ofisheljames108-ship-it/JF-Audio/README.md

# JF-Audio

A multi-generation Bluetooth speaker engineering project documenting the complete design process from prototype to custom PCB and beyond.

<p align="center">
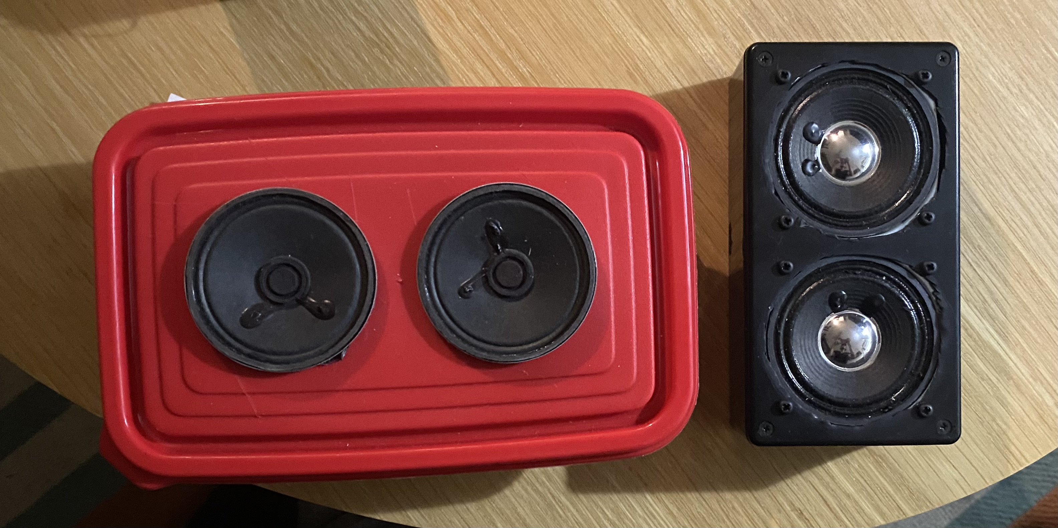
[picture p1: Images/JF_Audio_V1_V2_Comparison.jpeg]
  
</p>

This project follows the development of a portable Bluetooth speaker through multiple design iterations, beginning with a breadboard prototype and progressing toward a custom PCB-based system.

## Project Overview

JF-Audio is a personal electrical engineering project focused on designing and
developing a portable Bluetooth speaker system through multiple hardware
revisions.

The project began as a breadboard-based prototype using off-the-shelf modules
and has progressed into a custom PCB-based design integrating Bluetooth audio,
stereo amplification, rechargeable battery power, and enclosure development.

Each version of the project builds upon lessons learned from the previous
design.

---

## Project Generations

## Version 1 — Breadboard Prototype

The first version of JF-Audio was constructed using off-the-shelf modules and a breadboard to validate the Bluetooth audio system before designing custom hardware.

<p align="center">
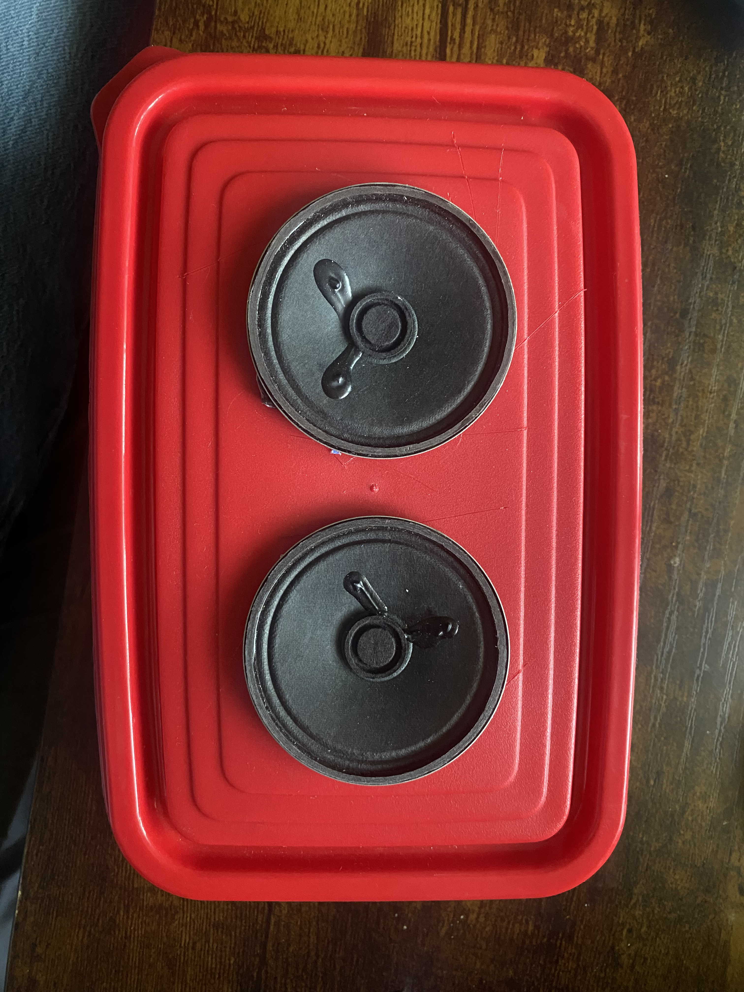
[picture p2: Version-1_Prototype/Photos/v1_finished_speaker.jpg]
  
</p>

The prototype was used to verify Bluetooth connectivity, stereo audio output, power distribution, and overall system functionality.

Key accomplishments:

- Bluetooth audio connectivity
- Stereo speaker output
- PAM8403 amplifier module integration
- Portable battery-powered operation
- Functional enclosure prototype

[View Version 1](Version-1_Prototype/)

---

## Version 2 — Custom PCB

Version 2 replaces the breadboard-based audio circuitry with a custom PCB
designed in EasyEDA. The board integrates the PAM8403 stereo audio amplifier,
passive components, Bluetooth connections, speaker outputs, and power
connections.

<p align="center">
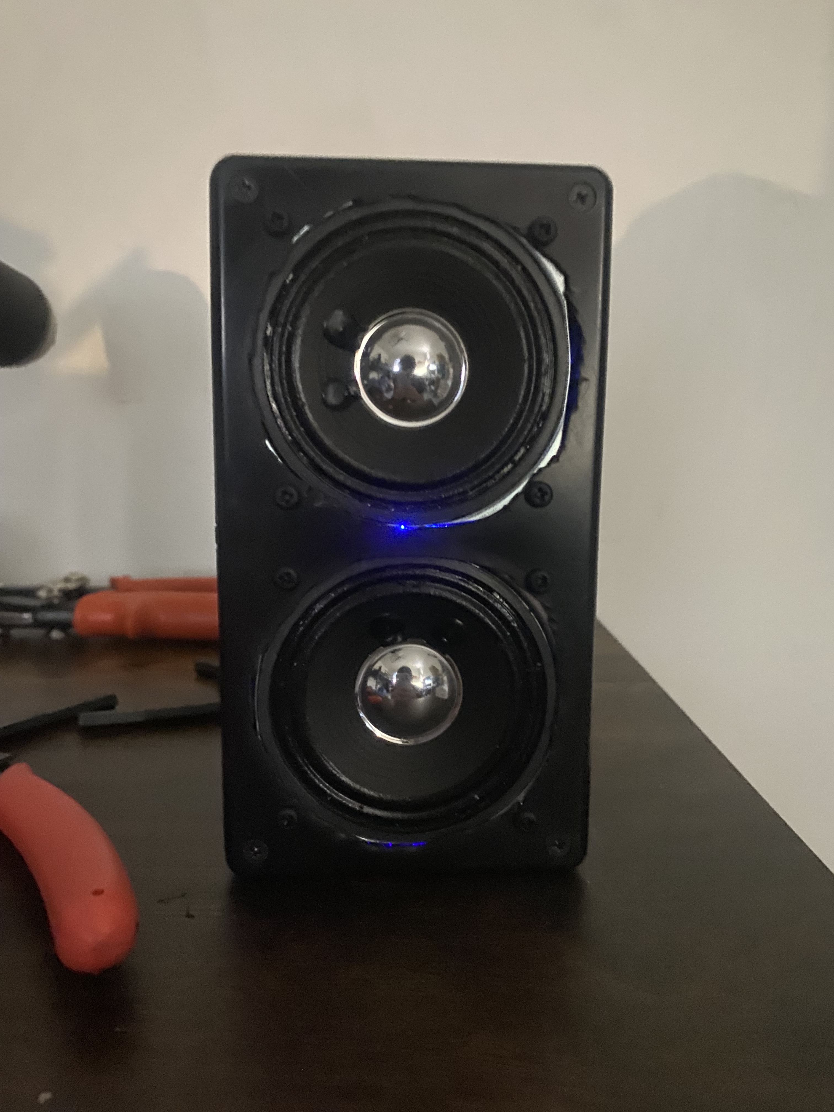
[picture p3: Version-2_Custom-PCB/Enclosure_Photos/Completed_JF_Audio_V2.jpg]
  
</p>

Version 2 transitioned JF Audio from a breadboard prototype into a custom
hardware platform.

The design introduced a custom PAM8403 amplifier PCB, rechargeable Li-ion
power system, battery protection, external power control, and a fully
integrated portable enclosure.

**Key accomplishments:**
- Custom PAM8403 amplifier PCB
- PCB manufacturing and hand assembly
- Rechargeable 18650 Li-ion power system
- Battery protection integration
- PowerBoost 1000C charging and power management
- External power switch
- Stereo Bluetooth playback
- Extended battery-powered playback testing
- Complete enclosure integration

**Current Status:** Final integration and validation. The assembled system has
successfully demonstrated Bluetooth connectivity, stereo audio playback,
battery-powered operation, charging, simultaneous charging and playback, and
a 2.5-hour post-assembly playback test.

The remaining mechanical issue is improving charging-port clearance to allow
the Micro-USB cable to fully seat, followed by final assembled charging and
charge-and-play validation.

[View Version 2](Version-2_Custom-PCB/)
---

### Version 3 — Integrated Product Design

**Planned**

Version 3 will focus on improving the mechanical and electronic integration
of JF Audio based on lessons learned during Version 2.

Planned development includes:
- Custom 3D-printed enclosure
- Purpose-designed component mounting locations
- Improved external connector integration
- Physical audio controls
- Improved audio processing
- More integrated electronics

### Version 4 — Advanced Embedded Audio System

**Planned**

Version 4 is intended to expand JF Audio into an advanced embedded audio
platform incorporating DSP, embedded control, system telemetry, display
integration, and deeper custom electronics.

### Version 5 — Advanced Hardware Platform

**Long-Term Concept**

Version 5 is intended to explore deeper custom hardware development,
advanced audio processing, custom display electronics, and increasingly
integrated system architecture.

---

## Design Philosophy

JF Audio follows an iterative engineering approach in which each generation
is used to identify limitations and establish requirements for the next design.

The project progression emphasizes:

- Increasing levels of custom hardware development
- Improved electrical and mechanical integration
- PCB design and hardware debugging
- Power-management and battery-system development
- Embedded control and digital signal processing
- Experimental testing and design validation
- Documentation of both successful designs and engineering challenges

Rather than treating each version as an independent project, lessons learned
from each generation directly influence the architecture of the next.

## Development Progress

**Version 1:** Complete  
**Version 2:** Hardware bring-up and enclosure integration in progress  
**Version 3:** Concept development

Version 2 has successfully demonstrated Bluetooth connectivity and stereo
audio operation using the custom PCB. Power-system integration and final
mechanical assembly are currently in progress.

---

## Engineering Areas

This project includes practical experience with:

- PCB schematic capture and layout
- EasyEDA
- PAM8403 Class-D audio amplification
- Bluetooth audio integration
- Lithium-ion battery power systems
- DC-DC power conversion
- Soldering and hardware assembly
- Digital multimeter testing
- PCB bring-up
- Hardware troubleshooting
- Enclosure design
- Design-for-assembly considerations
- Engineering documentation

---

## Repository Structure

```text
JF-Audio/
│
├── Version-1_Prototype/
│   └── Original breadboard-based Bluetooth speaker
│
├── Version-2_Custom-PCB/
│   └── Custom PCB, rechargeable power system, testing, and enclosure
│
├── Version-3_Concept/
│   └── Integrated electronics and custom enclosure development
|
├── Images/
│   └── Project-level images and generation comparisons
│
├── LICENSE
└── README.md
```
