ofisheljames108-ship-it/JF-Audio/Version-3_Concept/README.md

# JF Audio Version 3 — Concept Development

## Overview

JF Audio Version 3 is the planned next generation of the JF Audio Bluetooth
speaker platform.

Version 3 will build upon the electrical and mechanical lessons learned during
the development of Version 2, with a greater emphasis on product-level
integration, mechanical design, user controls, and serviceability.

Version 3 is currently in the concept and requirements-development phase.
Hardware specifications may change as the design progresses.

## Motivation

Version 2 successfully transitioned JF Audio from a breadboard prototype to a
rechargeable system built around a custom amplifier PCB.

However, final assembly identified several areas for improvement, particularly
in mechanical integration.

These observations directly establish several requirements for Version 3:

- Purpose-designed enclosure rather than a modified off-the-shelf enclosure
- Precisely dimensioned speaker openings and mounting features
- Dedicated mounting locations for internal electronics
- Improved charging-port integration
- Improved component accessibility and serviceability
- Cleaner internal wiring and system organization

## Preliminary Design Goals

Version 3 is expected to explore:

- Custom 3D-printed enclosure
- Purpose-designed internal component mounts
- Improved custom PCB integration
- USB-C charging
- Improved Bluetooth integration
- Physical volume control
- Mute control
- Playback controls
- User-selectable EQ functionality
- Status indicators
- Improved internal wiring and serviceability

## Preliminary Design Constraints

The final mechanical and electrical dimensions for Version 3 have not yet
been established. However, several preliminary constraints have been
identified from Version 2 development.

The enclosure must provide sufficient space and mounting provisions for:

- Two stereo speakers
- Custom JF Audio PCB
- Rechargeable lithium-ion battery system
- Power-management electronics
- Bluetooth audio hardware
- External power and user controls
- USB-C charging interface
- Internal wiring and connectors

Additional mechanical requirements include:

- Adequate clearance around external connectors
- Accessible mounting hardware
- Sufficient spacing for internal wiring
- Component placement that allows assembly and maintenance
- Accurate speaker mounting and acoustic openings
- Separation of mechanical features from sensitive PCB areas
- Allowance for future PCB revisions

Exact enclosure dimensions and component clearances will be established
during the CAD and system-layout phases.

## Design for Assembly and Serviceability

Version 3 will place greater emphasis on assembly and maintenance than
Version 2.

Where practical, the design will incorporate:

- Dedicated mounting features for major electronic components
- Accessible fasteners
- Reduced dependence on permanent adhesive mounting
- Improved cable routing
- Connector access without major disassembly
- Replaceable battery and electronic modules where practical
- PCB placement that permits inspection and troubleshooting
- Adequate clearance around charging and control interfaces

These requirements are intended to simplify assembly, troubleshooting,
maintenance, and future hardware revisions.

## Planned Engineering Areas

Development of Version 3 is expected to involve:

- Mechanical CAD
- 3D printing and enclosure prototyping
- PCB design
- Embedded control
- Audio electronics
- Power-management integration
- Bluetooth audio
- Digital audio control and/or signal processing
- System-level testing and validation

## Testing and Validation Strategy

Version 3 will adopt a more structured testing methodology based on lessons
learned during the development and documentation of Version 2.

Version 2 demonstrated the importance of recording not only whether a system
functioned, but also the hardware configuration, test procedure, measured
results, and criteria used to evaluate performance.

For Version 3, major validation tests will therefore be documented using a
standard test record containing:

- Date
- Hardware revision
- Hardware configuration
- Test objective
- Instruments used
- Test procedure
- Expected result
- Measured result
- Pass/fail criterion
- Conclusion

This structure will be used throughout electrical bring-up, subsystem
integration, enclosure validation, and final system testing.

Where appropriate, quantitative measurements such as voltage, current,
temperature, battery runtime, audio performance, and other relevant system
parameters will be recorded rather than relying solely on functional
observations.

The goal is to make Version 3 testing more reproducible, traceable, and useful
for evaluating design revisions.

## Planned Validation

Version 3 will undergo structured electrical, mechanical, and functional
validation before being considered complete.

Preliminary validation criteria include:

### Electrical

- Verify regulated system power
- Verify battery charging and protection
- Verify Bluetooth connectivity
- Verify left and right audio channels
- Verify physical user controls
- Verify status indicators
- Verify charging during normal system operation
- Monitor component temperatures during extended operation

### Mechanical

- Verify speaker alignment and mounting
- Verify PCB and module mounting
- Verify charging-port and control clearances
- Verify enclosure closure without wire or component interference
- Verify access to serviceable components
- Inspect internal cable routing and strain relief

### System

- Extended continuous playback test
- Battery-runtime characterization
- Charging and playback test
- Audio noise and distortion evaluation
- User-control functionality test
- Final assembled-system inspection

Specific quantitative acceptance criteria will be established as the
Version 3 architecture is finalized.

## Development Status

**Current Phase: Concept Development / Requirements Definition**

- [x] Version 2 limitations identified
- [x] Preliminary Version 3 objectives established
- [x] Design-for-assembly requirements identified
- [x] Structured testing methodology established
- [ ] System architecture finalized
- [ ] Preliminary mechanical dimensions established
- [ ] Enclosure CAD developed
- [ ] Electronic architecture finalized
- [ ] PCB designed
- [ ] Prototype manufactured
- [ ] Hardware integration completed
- [ ] System validation completed

## Relationship to Version 2

Version 3 is intended to address limitations identified during Version 2
rather than simply adding additional features.

The Version 2 development process demonstrated the importance of designing the
electrical and mechanical systems together. Version 3 will therefore place
greater emphasis on enclosure design, component placement, external-interface
clearance, and system integration from the beginning of development.
