ofisheljames108-ship-it/JF-Audio/Version-2_Custom-PCB/PCB/PCB_Design_Notes.md

# JF Audio Version 2 - PCB Design Notes

## Overview

The JF Audio Version 2 PCB was designed to replace the breadboard-based wiring used in Version 1 with a more compact, organized, and permanent electrical system.

Version 1 successfully demonstrated the operation of the Bluetooth speaker, but the use of a breadboard, jumper wires, and separate modules required a significant amount of enclosure space and resulted in a large number of point-to-point connections.

Version 2 moves these connections onto a custom printed circuit board while also integrating the audio amplifier circuitry directly onto the PCB.

The PCB was designed and routed using EasyEDA and was submitted for fabrication after completing Design Rule Checking (DRC).

---

## Design Objectives

The primary objectives of the PCB were:

- Replace breadboard wiring with PCB traces
- Reduce the amount of point-to-point wiring
- Integrate the audio amplifier circuitry directly onto the PCB
- Provide dedicated connections for the Bluetooth module
- Provide dedicated left and right speaker connections
- Provide connections for the rechargeable power system
- Improve power and ground distribution
- Use wider traces for higher-current paths
- Maintain organized audio and power routing
- Create a PCB that can be mounted inside a dedicated enclosure
- Gain experience with schematic capture, footprint creation, PCB routing, vias, copper regions, and DRC

---

# PCB Design

## Top PCB Layout

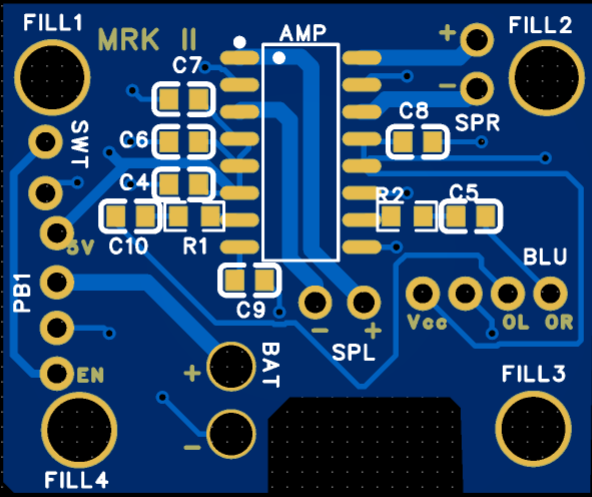
[picture p15: Version-2_Custom-PCB/PCB/Photos/PCB_2D_Top.png]
JF Audio Version 2 PCB Top Layout


The top PCB layout shows the component footprints, copper traces, through-hole connections, mounting holes, and amplifier circuitry.

The amplifier was positioned near the center of the PCB with its supporting passive components located nearby. Connections for the Bluetooth module, speakers, battery, external switch, and power system were positioned around the perimeter of the board where practical.

Component placement was selected to keep related components close together and reduce unnecessary trace lengths.

---

## Top PCB 3D Model

JF Audio Version 2 PCB 3D Top

The EasyEDA 3D model was used to inspect the physical arrangement of the components before the PCB was submitted for fabrication.

The 3D model helped verify:

- Component placement
- Component orientation
- Connector locations
- Component spacing
- Mounting-hole locations
- Silkscreen placement
- Overall PCB dimensions and proportions

This provided an additional design review before manufacturing the physical board.

---

## Bottom PCB Layout

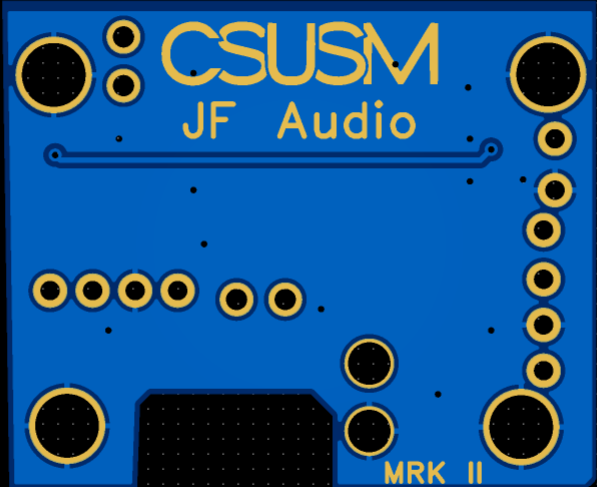
[picture p16: Version-2_Custom-PCB/PCB/Photos/PCB_2D_Bottom.png]
JF Audio Version 2 PCB Bottom Layout


The bottom PCB layout contains additional routing, vias, through-hole connections, and project identification.

The use of both PCB layers made it possible to route connections that would have been difficult to complete entirely on a single layer.

Vias were used where necessary to transition electrical connections between the top and bottom copper layers.

---

## Bottom PCB 3D Model

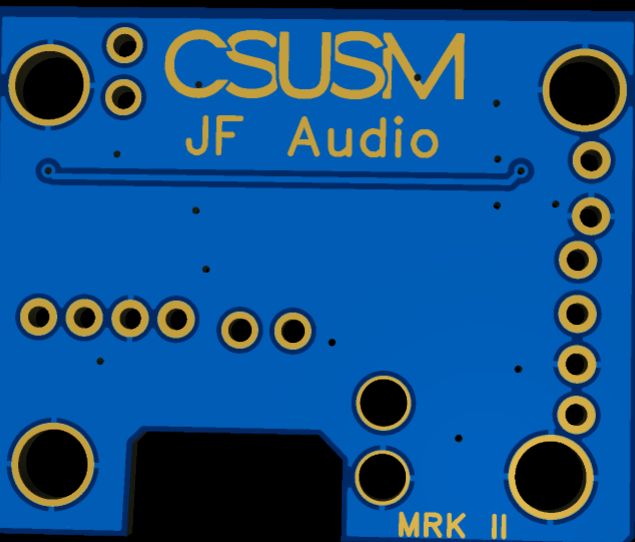
[picture p17: Version-2_Custom-PCB/PCB/Photos/PCB_3D_Bottom.png]
JF Audio Version 2 PCB 3D Bottom


The bottom side of the PCB includes custom project identification.

The silkscreen includes:

- CSUSM
- JF Audio
- MRK II

The **MRK II** designation identifies the PCB as part of the second major hardware revision of the JF Audio speaker.

---

# Audio System

## Audio Amplifier Section

Unlike Version 1, which used a complete PAM8403 amplifier module, Version 2 integrates the audio amplifier IC and its supporting components directly onto the custom PCB.

This reduces dependence on a separate amplifier breakout board and allows the amplifier circuitry to become part of the main speaker PCB.

The supporting passive components were positioned near the amplifier where practical to reduce unnecessary trace lengths and maintain an organized audio section.

---

## Audio Signal Routing

The PCB provides separate left and right audio paths between the Bluetooth receiver and the amplifier.

The signal flow can be represented as:

Bluetooth Receiver

↓

Left / Right Audio Signals

↓

Audio Amplifier

↓

Left / Right Amplified Outputs

↓

Speakers

The audio-input traces were routed separately from the higher-current speaker-output paths where practical.

---

## Speaker Outputs

The amplifier provides separate positive and negative outputs for each speaker channel.

The PCB therefore provides connections for:

- Left Speaker +
- Left Speaker -
- Right Speaker +
- Right Speaker -

Each speaker connects between the positive and negative amplifier outputs for its corresponding channel.

The negative speaker terminals are amplifier outputs and are **not connected directly to ground**.

Wider traces were used for the speaker-output paths because these connections can carry more current than the low-level audio-input signals.

---

# Power System

## Power Architecture

Version 2 moves away from the four-AA battery system used in Version 1 and introduces a rechargeable battery architecture.

The external power circuitry provides the required supply voltage for the PCB, which is then distributed to the Bluetooth receiver and amplifier circuitry.

This addresses one of the major limitations of Version 1, which did not include an integrated rechargeable battery system.

---

## Power Routing

Power traces were made wider than low-current signal traces where practical.

Particular attention was given to higher-current connections such as:

- Main power input
- Amplifier power
- Speaker outputs
- Battery/power connections

Using wider copper traces reduces resistance and improves the ability of the PCB to carry current.

---

# Grounding

Ground distribution was an important consideration during PCB layout.

A copper ground region was used to provide a common low-impedance ground connection across the PCB and reduce the need for long individual ground traces.

The Bluetooth receiver, amplifier circuitry, power system, and supporting passive components ultimately share the system ground.

Grounding was also considered during audio routing because poor ground connections can contribute to unwanted noise in an audio system.

---

# Component Placement

## Amplifier Components

The components associated with the amplifier were grouped together near the amplifier IC.

This helps:

- Reduce unnecessary trace lengths
- Keep the amplifier section organized
- Simplify routing
- Keep supporting components close to their associated IC pins

The manufactured PCB demonstrated that electrical compactness also needs to be balanced against physical accessibility during assembly and rework. This became an important consideration for future revisions.

---

## Capacitor Placement

Capacitor placement was an important consideration during PCB design.

Power-related capacitors were placed close to the amplifier and associated supply connections where practical.

This reduces the distance between the amplifier and its local energy-storage and decoupling components.

A larger 470 µF bulk capacitor is also used on the regulated power rail to help support the amplifier during changing load conditions.

During physical assembly, an issue was discovered with the PCB footprint originally assigned to this capacitor. This issue and its solution are documented later in the PCB Bring-Up section.

---

# PCB Routing

## Trace Widths

Different trace widths were selected depending on the expected function of each connection.

### Wider Traces

Wider traces were used for higher-current connections such as:

- Main power distribution
- Amplifier power
- Battery/power connections
- Left speaker output
- Right speaker output

### Signal Traces

Smaller traces were used for lower-current connections such as:

- Left audio input
- Right audio input
- Control connections
- Other low-current signals

This allowed more copper to be dedicated to higher-current paths while keeping the remaining PCB routing manageable.

---

## Via Usage

Vias were used where necessary to transition traces between the top and bottom copper layers.

Several routing areas around the amplifier and other connections were difficult to complete on a single PCB layer.

Using vias allowed traces to move to the opposite layer, pass around existing routing, and return to the original layer when necessary.

This provided additional routing flexibility while maintaining the required electrical connections.

---

# Footprint Development

Several component and footprint configurations required additional work during the design process.

Custom components and footprints were created in EasyEDA where necessary.

One issue encountered during development was EasyEDA reporting that a component lacked a footprint even though a footprint had already been created.

This required verifying that the correct footprint was actually assigned to the corresponding schematic component rather than relying only on matching component and footprint names.

This provided practical experience with the relationship between:

- Schematic symbols
- PCB footprints
- Physical components
- Pad assignments
- Net assignments

The physical assembly process also demonstrated the importance of verifying the actual package dimensions of components before manufacturing. An electrically correct component value does not guarantee that the selected PCB footprint will physically accommodate the intended component.

---

# Routing and Net Troubleshooting

Several routing and net-related issues were encountered during PCB development.

Some connections appeared correct visually but were still reported as electrically disconnected.

Troubleshooting involved checking:

- Net assignments
- Net names
- Pad assignments
- Physical trace connections
- Layer transitions
- Via connections
- Copper continuity
- Clearance requirements

Vias were used in difficult routing areas to transition between PCB layers and complete the required electrical connections.

This demonstrated that matching net labels alone do not guarantee that a continuous physical copper connection exists on the PCB.

---

# Design Rule Checking

Design Rule Checking was performed throughout the PCB development process.

DRC was used to identify potential problems including:

- Unconnected nets
- Routing conflicts
- Clearance violations
- Copper-region issues
- Via-related problems
- Other PCB design-rule violations

Each reported issue was investigated and corrected.

The final PCB design reached:

**0 DRC Errors**

before being submitted for manufacturing.

The physical assembly process later demonstrated that passing DRC confirms compliance with the configured electrical and manufacturing rules, but does not replace a detailed review of component dimensions, assembly accessibility, and rework clearance.

---

# Silkscreen and Board Identification

The PCB includes custom silkscreen markings to identify the project and board revision.

JF Audio Version 2 Bottom Silkscreen

The bottom side includes:

**CSUSM**

**JF Audio**

**MRK II**

These markings distinguish Version 2 from the original JF Audio prototype and provide identification for the custom PCB.

---

# Manufacturing Preparation

Before submitting the PCB for fabrication, the design was reviewed for:

- Component placement
- Component orientation
- Trace routing
- Power connections
- Speaker connections
- Audio connections
- Ground connectivity
- Via placement
- Footprint assignments
- Silkscreen placement
- Mounting-hole placement
- Design Rule Check results

After the final review and successful DRC, the PCB was submitted for manufacturing.

The fabrication files are being kept separately from the public project documentation.

---

# PCB Bring-Up & Assembly Notes

After receiving the manufactured PCB, the board was visually inspected and tested for continuity before power was applied.

Continuity testing confirmed the expected power, ground, and signal connections across the PCB and did not identify unintended shorts between the main supply and ground rails.

## C10 Bulk Capacitor Footprint Issue

During physical assembly, it was discovered that the footprint selected for C10 was too small for the intended 470 µF electrolytic bulk capacitor.

Because the manufactured PCB could not physically accommodate the required capacitor at the original C10 location, the capacitor was instead connected externally across the regulated 5 V and GND supply rails feeding the PCB.

This allowed the existing PCB revision to remain usable while identifying a footprint correction for a future board revision.

The issue demonstrated the importance of verifying both the electrical value and the physical package dimensions of a component before PCB fabrication.

## Assembly and Rework Challenges

The compact PCB successfully reduced the amount of enclosure space and point-to-point wiring required compared with Version 1.

However, the dense placement around the PAM8403 audio amplifier and its supporting surface-mount components made hand soldering and rework more difficult.

During rework near the amplifier section, the limited clearance between components made it possible for heat from the soldering iron or excess solder to affect neighboring small capacitors.

This demonstrated that minimizing PCB size must be balanced against:

- Electrical performance
- Manufacturability
- Hand assembly
- Soldering accessibility
- Testing
- Troubleshooting
- Repairability

Although increasing the overall PCB dimensions could provide additional working space, future revisions can also improve assembly by changing component placement rather than simply increasing the entire board size.

---

## Improvements for the Next PCB Revision

Future PCB revisions should include:

- Correct C10 footprint for the 470 µF polarized electrolytic capacitor
- Increased working clearance around the PAM8403
- Increased clearance between small passive components where practical
- Larger or dedicated 5 V and GND solder pads
- Dedicated test points for important power and signal connections
- Improved access to solder joints used for external wiring
- Placement of off-board wire connections near PCB edges where practical
- Improved silkscreen spacing and reference-designator placement
- Consideration of larger passive-component packages where practical for easier hand soldering and rework
- Continued use of short amplifier power and decoupling paths while improving physical accessibility
- Additional consideration of assembly and serviceability during component placement

The goal for the next PCB revision is therefore not simply to make the board larger, but to improve component placement and serviceability while retaining the compact integration achieved in Version 2.

---

## Hardware Verification Progress

Initial powered testing of the manufactured Version 2 PCB has now been
completed.

Testing successfully verified:

- Approximately 5.1 V supply to the PCB during initial power testing
- Bluetooth receiver power and connectivity
- Successful Bluetooth pairing
- PAM8403 left audio channel operation
- PAM8403 right audio channel operation
- Successful stereo speaker output

These results confirmed successful operation of the primary Version 2
Bluetooth audio signal path:

Bluetooth Receiver → JF Audio PCB → PAM8403 Amplifier → Left/Right Speakers

During subsequent power-system testing, an issue developed with the
PowerBoost 1000C. The module stopped producing the expected boosted output
and exhibited abnormal heating near the boost-converter IC. Further testing
of that module was discontinued, and a replacement PowerBoost will be used
for continued system testing.

The exact cause of the PowerBoost failure has not been conclusively
determined.

Detailed electrical measurements, test results, and troubleshooting are
documented separately in:

[Hardware Testing](../Testing/Hardware_Testing.md)

Remaining verification includes:

1. Install and verify the 1S lithium-ion battery protection module.
2. Install and test the replacement PowerBoost 1000C.
3. Verify the complete rechargeable power and charging system.
4. Verify external power-switch operation.
5. Perform extended stereo playback testing.
6. Check for unwanted audio noise or distortion.
7. Install and test the completed electronics inside the final enclosure.

---

# Improvements Over Version 1

| Version 1 | Version 2 |
|---|---|
| Breadboard-based construction | Custom PCB |
| PAM8403 amplifier module | Amplifier circuitry integrated onto PCB |
| Large number of jumper wires | PCB trace routing |
| Four AA batteries | Rechargeable battery system |
| No integrated battery charging | Rechargeable power architecture |
| Modified food container | Dedicated plastic enclosure |
| Large internal wiring footprint | More compact electrical system |
| Prototype-oriented construction | More permanent hardware design |

The custom PCB represents one of the largest improvements between the two versions because it replaces much of the point-to-point wiring used in the original prototype.

---

## Current Status

### PCB Development

- [x] Custom PCB designed
- [x] PCB design-rule checks completed
- [x] PCB manufactured
- [x] PCB assembled
- [x] Electrical continuity and power testing completed
- [x] PAM8403 amplifier operation verified
- [x] Stereo audio operation verified

### System Integration

- [x] Battery protection module integrated
- [x] Replacement PowerBoost 1000C integrated
- [x] Extended playback testing completed
- [x] Enclosure integration completed
- [ ] Final assembled charging-port validation

> Detailed system-level testing, measurements, and troubleshooting are
> documented in the Version 2 hardware-testing documentation.

---

# Summary

The JF Audio Version 2 PCB represents the transition from the breadboard-based proof of concept developed in Version 1 to a purpose-built hardware design.

The PCB design process provided practical experience with schematic development, custom footprints, component placement, trace routing, trace sizing, grounding, copper regions, vias, design-rule checking, and preparing a custom PCB for manufacturing.

Physical assembly of the manufactured PCB also provided experience with PCB bring-up, continuity testing, component-footprint verification, soldering, rework, and troubleshooting.

The first manufactured revision demonstrated that a compact PCB can successfully reduce wiring and enclosure space, but also showed the importance of considering physical assembly and repairability during component placement.

With the manufactured PCB received and initial continuity verification completed, the current stage of the project focuses on hardware assembly, powered electrical measurements, audio-system testing, troubleshooting, and final integration into the Version 2 enclosure.

Lessons from Version 2 will also be used to guide a future PCB revision with improved component spacing, soldering accessibility, test points, and serviceability.
