ofisheljames108-ship-it/JF-Audio/Version-2_Custom-PCB/Enclosure_Photos/Charging_Port_Opening.jpg

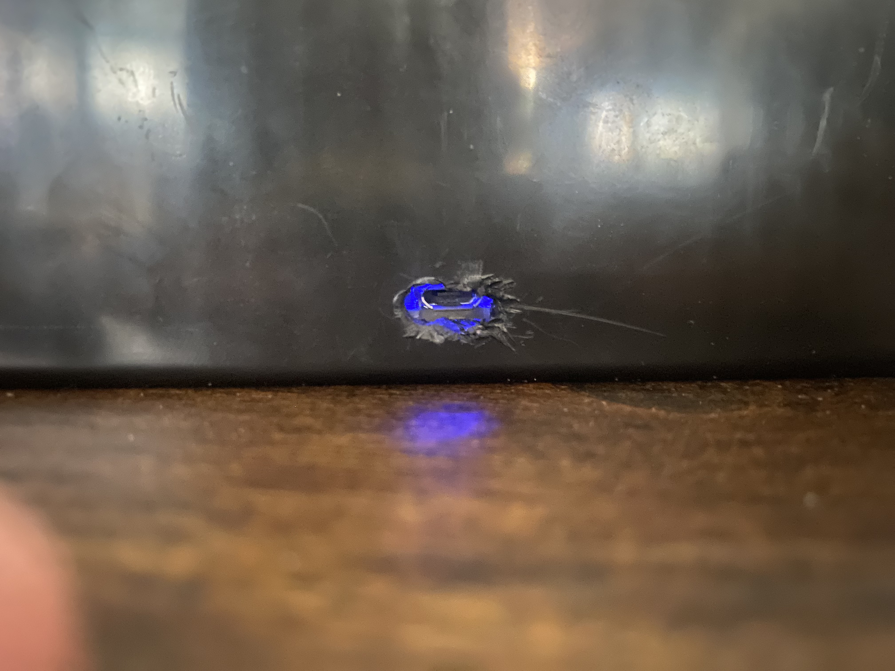
Version-2_Custom-PCB/Enclosure_Photos/Charging_Port_Opening.jpg
