ofisheljames108-ship-it/JF-Audio/Version-2_Custom-PCB/Schematics/JF_Audio_V2_Schematic.png

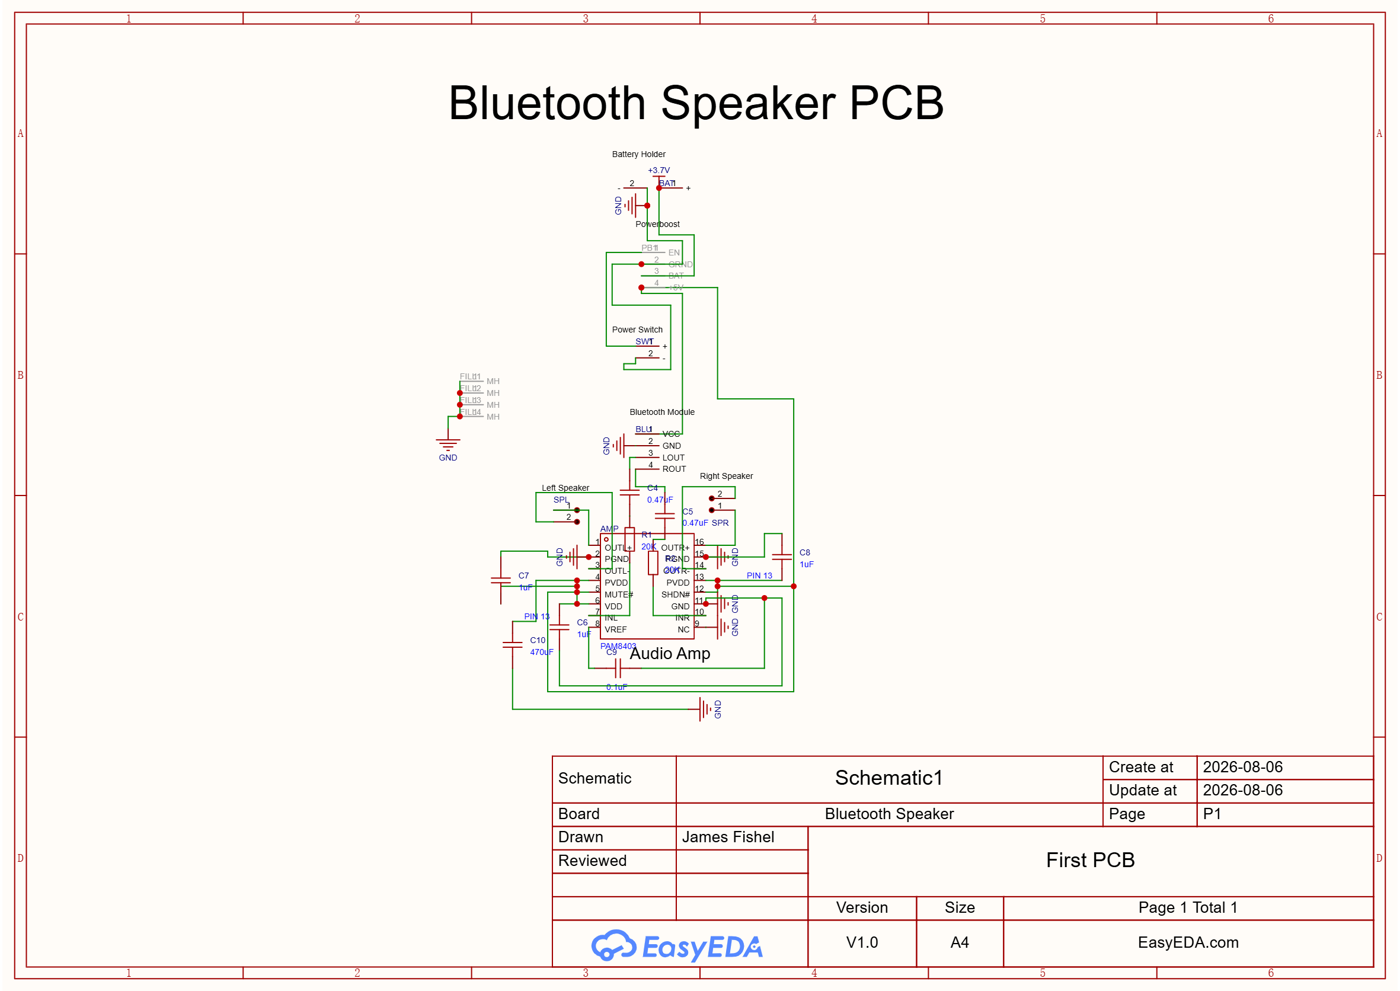
Version-2_Custom-PCB/Schematics/JF_Audio_V2_Schematic.png
