ofisheljames108-ship-it/JF-Audio/Version-2_Custom-PCB/PCB/Manufacturing/BOM/JF_Audio_V2_BOM.xlsx

No. | Quantity | Comment | Designator | Footprint | Value | Manufacturer Part | Manufacturer | Supplier Part | Supplier | Layer
1 | 1 | PAM8403 | AMP | SOP-16_L10.0-W3.9-P1.27-LS6.0-BL |  | PAM8403 | Slkor(萨科微) | C5122557 | LCSC | T
2 | 1 | Battery Holder | BAT | Battery Holder |  |  |  |  |  | T
3 | 1 | Bluetooth Audio Reciever | BLU | Bluetooth Audio Reciever |  |  |  |  |  | T
4 | 2 | 0.47uF | C4,C5 | C0603 | 0.47uF |  |  |  |  | T
5 | 3 | 1uF | C6,C7,C8 | C0603 | 1uF |  |  |  |  | T
6 | 1 | 0.1uF | C9 | C0603 | 0.1uF |  |  |  |  | T
7 | 1 | 470uF | C10 | C0603 | 470uF |  |  |  |  | T
8 | 2 | 20K | R1,R2 | R0603 | 20K |  |  |  |  | T
9 | 2 | GF0668 Speaker | SPL,SPR | GF0668 Spealer |  |  |  |  |  | T
10 | 1 | Power Switch | SWT | Power Switch |  |  |  |  |  | T
