ofisheljames108-ship-it/JF-Audio/Version-2_Custom-PCB/PCB/Photos/PCB_Manufactured_Bottom.jpeg

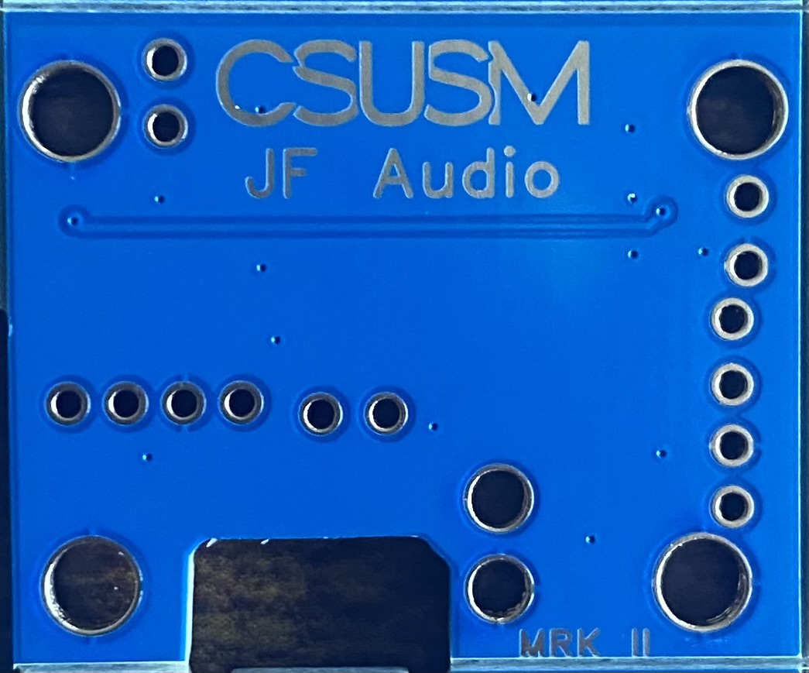
Version-2_Custom-PCB/PCB/Photos/PCB_Manufactured_Bottom.jpeg
