ofisheljames108-ship-it/JF-Audio/Version-3_Concept/Testing/Hardware_Testing.md

# JF Audio Version 3 - Hardware Testing

## Overview

This document will record the electrical, functional, mechanical, thermal,
audio, power-system, and system-level validation performed during development
of JF Audio Version 3.

Unlike Version 2, Version 3 establishes a standardized testing methodology
before hardware development and integration begin.

Major validation tests will be documented using the test-record format defined
below to improve reproducibility, traceability, and comparison between design
revisions.

---

## Standard Test Record

The following template will be used for major Version 3 validation tests.

### Test: [Test Name]

**Date:**  
**Hardware Revision:**  
**Hardware Configuration:**  
**Test Objective:**  
**Instruments Used:**  

#### Procedure

1. 
2. 
3. 

#### Expected Result

[Define the expected system behavior or measurement before testing.]

#### Measured Result

[Record measured values and observed behavior.]

#### Pass/Fail Criterion

[Define the condition required for the test to pass.]

#### Conclusion

**Result:** PASS / FAIL / PARTIAL

[Summarize the result, abnormalities, and any required corrective action.]

---

## Planned Testing

Testing is expected to include:

### Electrical
- Initial PCB inspection and continuity testing
- Power-rail verification
- Battery-system validation
- Charging-system validation
- Power-consumption measurements

### Audio
- Left and right channel verification
- Stereo playback
- Audio noise evaluation
- Audio distortion evaluation
- Volume-control verification
- EQ/control verification, if implemented

### Bluetooth and Controls
- Bluetooth pairing and reconnection
- Playback-control verification
- Physical control verification
- Status-indicator verification

### Thermal and Endurance
- Component temperature evaluation
- Extended playback testing
- Battery-runtime characterization
- Charging-and-playback testing

### Mechanical
- Speaker fit and alignment
- PCB and module mounting
- Connector and control clearances
- Internal wiring and cable routing
- Enclosure assembly
- Serviceability evaluation

### Final System Validation
- Fully assembled power-on test
- Bluetooth and stereo playback
- User-control functionality
- Extended assembled-system playback
- Charging through the final enclosure
- Final electrical inspection
- Final mechanical inspection

---

## Test Records

Individual test records will be added below as Version 3 hardware development
progresses.
