ofisheljames108-ship-it/JF-Audio/Version-2_Custom-PCB/Testing/Photos/PowerBoost_Troubleshooting.jpeg

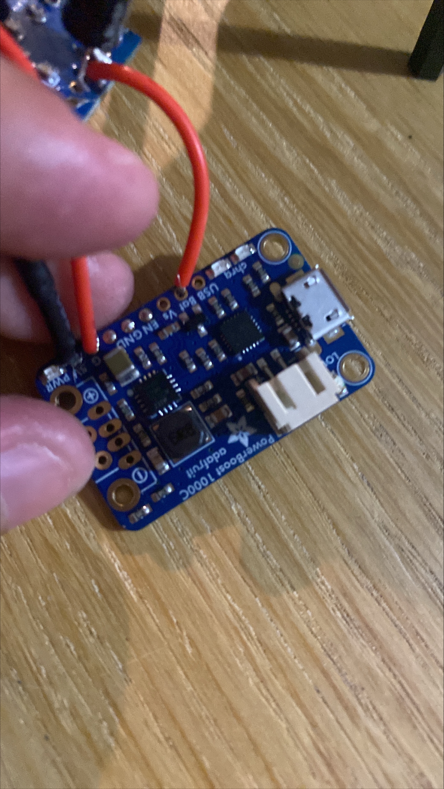
Version-2_Custom-PCB/Testing/Photos/PowerBoost_Troubleshooting.jpeg
