ofisheljames108-ship-it/JF-Audio/Version-2_Custom-PCB/Schematics/JF_Audio_V2_Schematic.pdf

# Bluetooth Speaker PCB

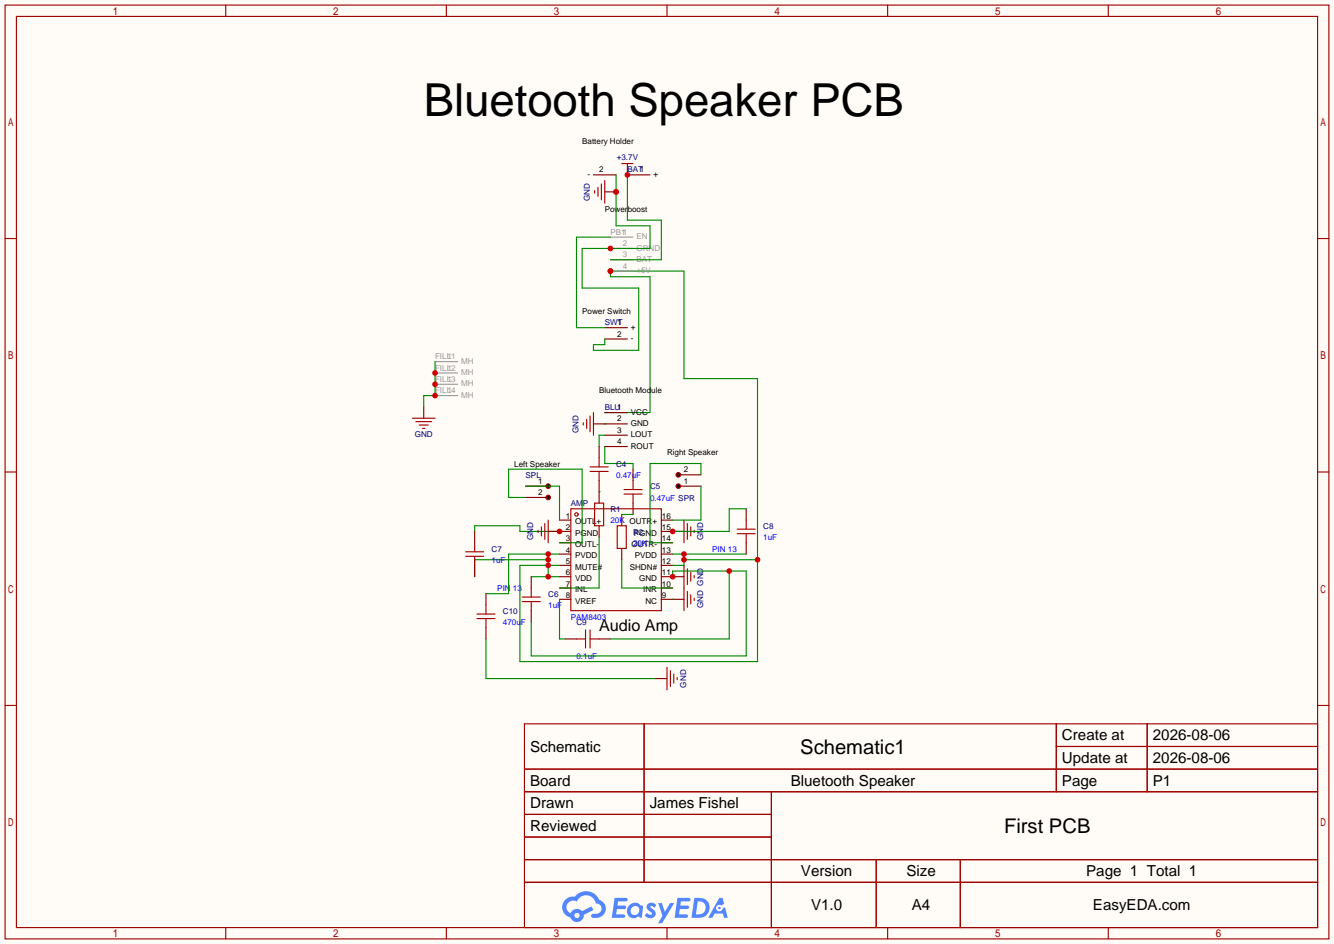
[picture p25: page 1]

Schematic | Schematic1 | Create at | 2026-08-06

Update at | 2026-08-06

Board | Bluetooth Speaker | Page | P1
Drawn | James Fishel | First PCB
Reviewed

Version | Size | Page 1 Total 1
V1.0 | A4 | EasyEDA.com
