ofisheljames108-ship-it/JF-Audio/(commit log)

2026-08-09 Revise README for JF Audio Version 1 prototype
    Updated the README to clarify the project goals, design goals, and lessons learned from the JF Audio Version 1 prototype. Added images and improved descriptions for better understanding.
2026-08-09 Revise README for power system and version updates
    Updated README to clarify power system details and version progression.
2026-08-09 Add parts list and design notes for JF Audio Version 1
    This document outlines the components and materials for the JF Audio Bluetooth speaker prototype, including details on the power system and design approach.
2026-08-10 Revise README.md for improved project documentation
    Updated README.md to enhance clarity and detail in the project description, system architecture, and power system sections.
2026-08-10 Revise README for JF Audio Version 1 prototype
    Updated the README.md to enhance clarity and detail about the JF Audio Version 1 prototype, including improvements in wording, added specifications, and refined descriptions of the system architecture and lessons learned.
2026-08-10 Add PCB design notes for JF Audio Version 2
    Document the design objectives, layout, and improvements of the JF Audio Version 2 PCB. Include details on component placement, routing, and manufacturing preparation.
2026-08-15 Update PCB design notes with assembly and revision insights
    Added notes on PCB assembly challenges and improvements for future revisions, including issues with capacitor footprint and assembly accessibility.
2026-08-18 Add hardware testing documentation for JF Audio V2
    Documented the hardware testing process for JF Audio Version 2, including initial setup, PCB inspection, power testing, Bluetooth receiver functionality, audio amplifier testing, and troubleshooting of the PowerBoost module. Also outlined improvements to battery protection and future testing plans.
2026-08-18 Enhance README with PCB design details and images
    Added detailed descriptions of the PCB layout and design, including information about trace widths and ground connections. Included images of the PCB layout and manufactured board.
2026-08-26 Add hardware testing results for Version 2 system
    Documented results of integrated system tests, initial playback tests, extended playback tests, battery charging tests, and simultaneous charging and playback tests for Version 2 electronics.
2026-08-26 Document enclosure and mechanical fit testing
    Added enclosure and mechanical fit testing details, including dimensions and testing status.
2026-09-06 Document enclosure integration and playback test results
    Added details about enclosure integration and post-assembly playback testing, including mechanical design observations and results.
2026-09-06 Revise Version 2 status to final testing phase
    Updated the current status of Version 2 to reflect final testing progress and changes in tasks related to enclosure integration.
2026-09-07 Change image source for Version 2 PCB
    Updated image reference for Version 2 in README.
2026-09-09 Revise README for Version 2 status and next steps
    Updated the README to reflect the current status and next steps for Version 2, including changes in terminology and task completion.
2026-09-09 Revise final testing and summary details
    Updated final system testing and testing summary sections with completed tests and remaining validation tasks. Clarified issues with the PowerBoost 1000C and improvements to the battery architecture.
