ofisheljames108-ship-it/JF-Audio/Version-1_Prototype/Photos/v1_breadboard_wiring.jpg

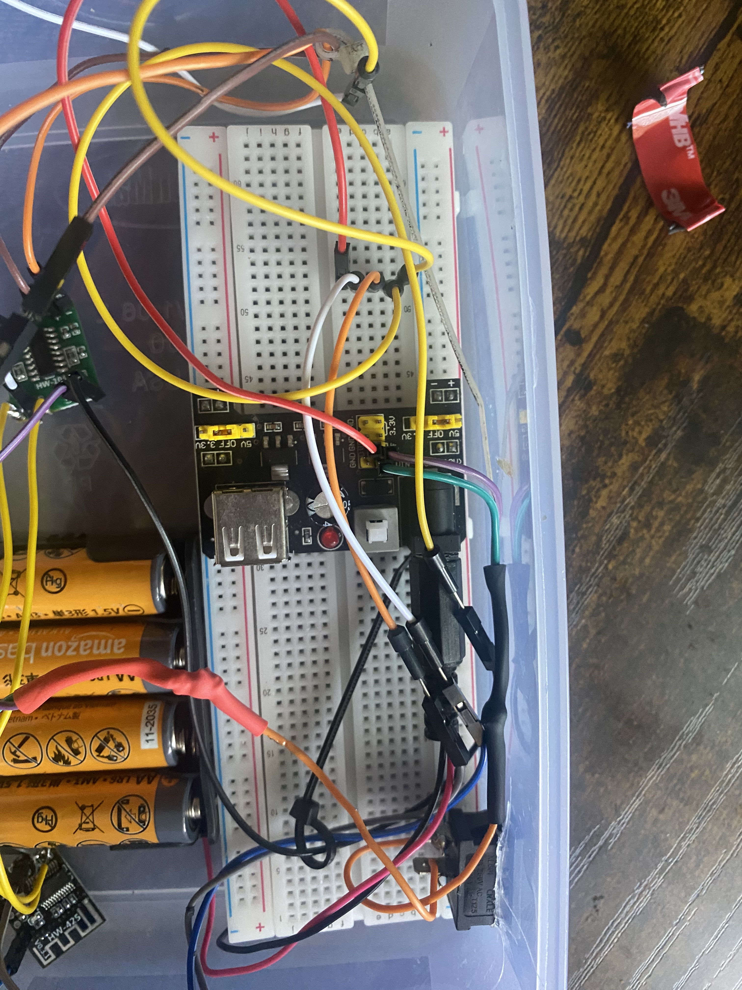
[picture p12: Version-1_Prototype/Photos/v1_breadboard_wiring.jpg]
Version-1_Prototype/Photos/v1_breadboard_wiring.jpg
