ofisheljames108-ship-it/JF-Audio/Version-2_Custom-PCB/Testing/Photos/Initial_Bench_Test.jpeg

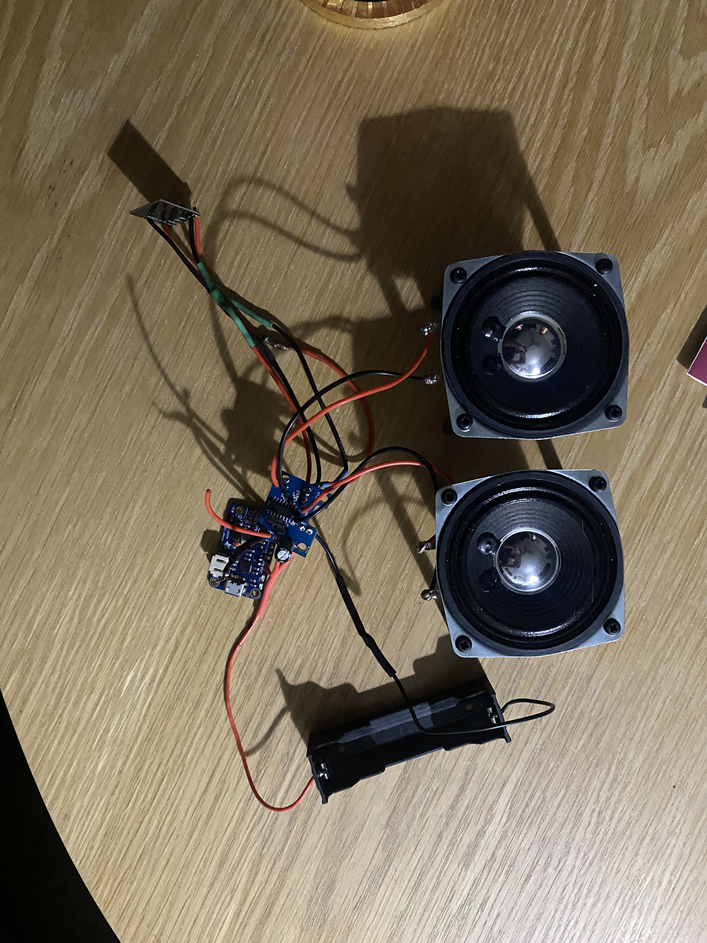
[picture p21: Version-2_Custom-PCB/Testing/Photos/Initial_Bench_Test.jpeg]
Version-2_Custom-PCB/Testing/Photos/Initial_Bench_Test.jpeg
