ofisheljames108-ship-it/JF-Audio/Version-2_Custom-PCB/Testing/Photos/PowerBoost_Wiring_Top.jpeg

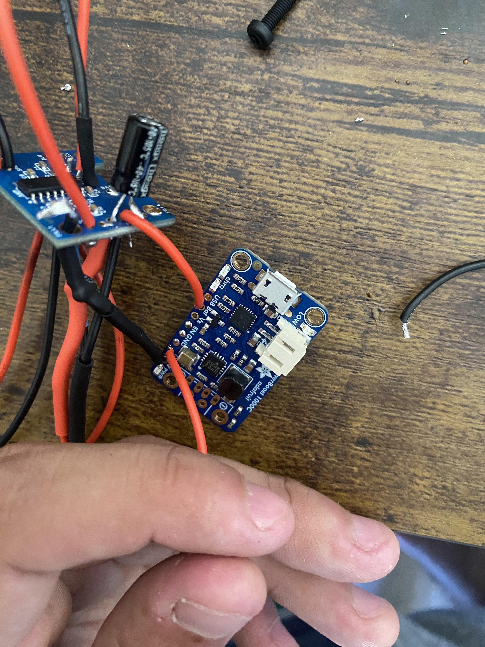
[picture p22: Version-2_Custom-PCB/Testing/Photos/PowerBoost_Wiring_Top.jpeg]
Version-2_Custom-PCB/Testing/Photos/PowerBoost_Wiring_Top.jpeg
