ofisheljames108-ship-it/JF-Audio/Version-2_Custom-PCB/Testing/Photos/PowerBoost_Wiring_Bottom.jpeg

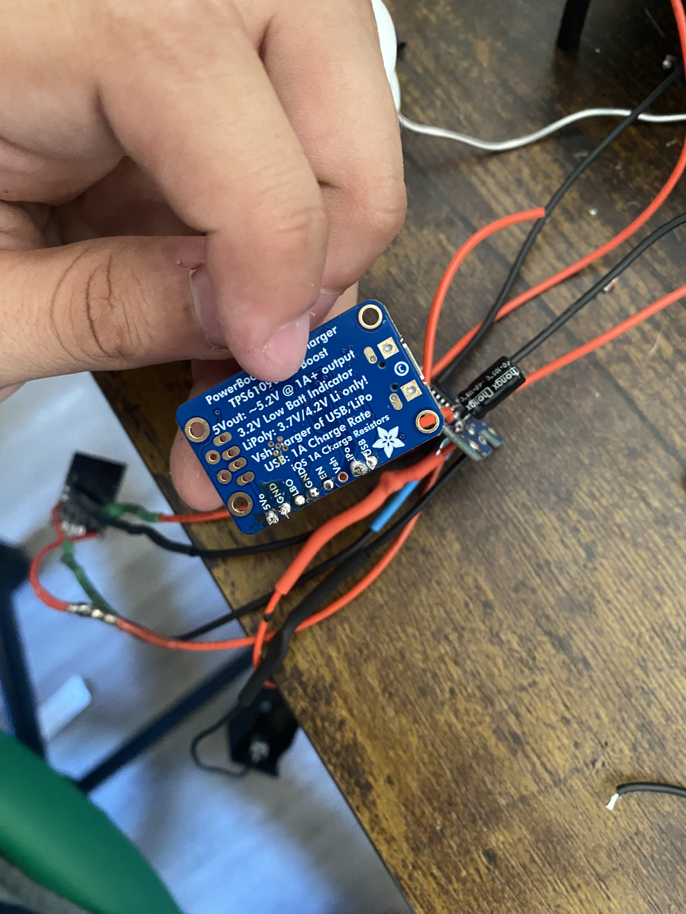
[picture p23: Version-2_Custom-PCB/Testing/Photos/PowerBoost_Wiring_Bottom.jpeg]
Version-2_Custom-PCB/Testing/Photos/PowerBoost_Wiring_Bottom.jpeg
